N-Magi/NixieClockLogicModuleV2/readme.md

# NixieClockLogicModule v.2

new Version of NixieClock LogicModule mar fix wire ploblem

## How To Use

it's made from platformIo
open project as PIO project then connect to your microContoroller board and upload
