N-Magi/NixieClockLogicModuleV2/nixieLogicV2/nixieLogicV2.kicad_pcb

## KiCad design nixieLogicV2/nixieLogicV2.kicad_pcb (2020-12-06)

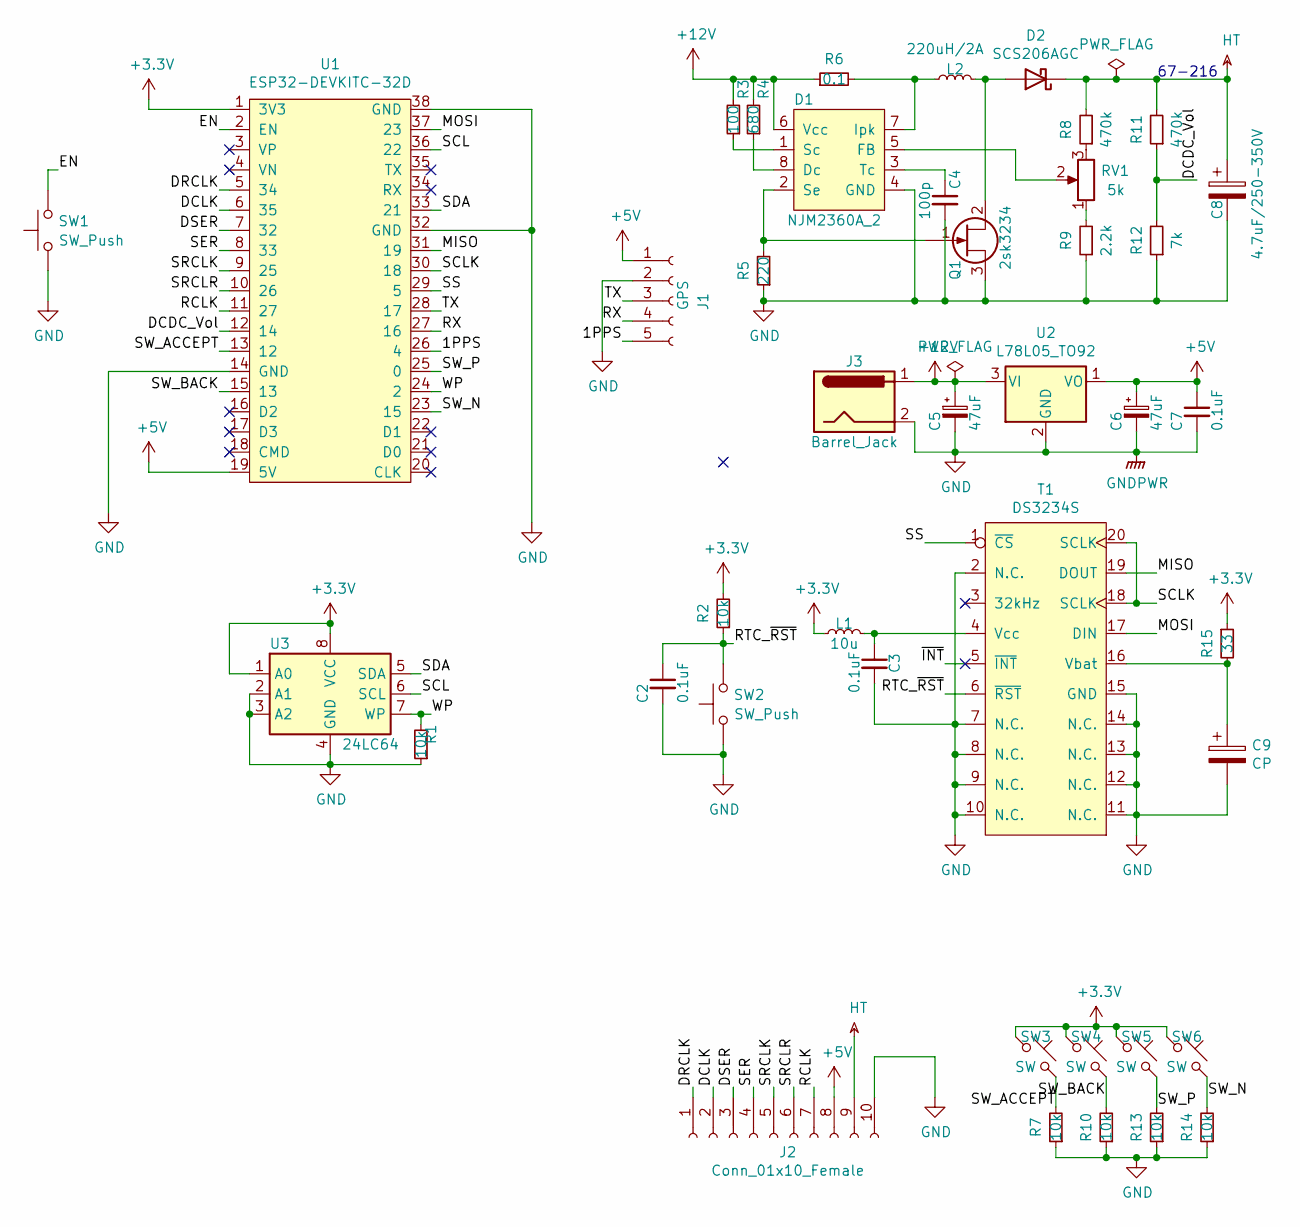
[picture p1: schematic nixieLogicV2.sch]

Parts:
C2, C3, C7: 0.1uF; C_0805_2012Metric_Pad1.15x1.40mm_HandSolder
C4: 100p; C_Rect_L7.2mm_W2.5mm_P5.00mm_FKS2_FKP2_MKS2_MKP2
C5, C6: 47uF; CP_Radial_D5.0mm_P2.00mm
C8: 4.7uF/250-350V; CP_Radial_D10.0mm_P5.00mm
C9: CP; CP_Radial_D14.0mm_P5.00mm
D1: NJM2360A_2; DIP-8_W7.62mm_Socket_LongPads
D2: SCS206AGC; TO-220-2_Horizontal_TabDown
J1: GPS; PinHeader_1x05_P2.54mm_Vertical
J2: Conn_01x10_Female; PinHeader_1x10_P2.54mm_Vertical
J3: Barrel_Jack; BarrelJack_Horizontal
L1: 10u; L_1206_3216Metric_Pad1.42x1.75mm_HandSolder
L2: 220uH/2A; L_Toroid_Vertical_L16.0mm_W8.0mm_P7.62mm
Q1: 2sk3234; TO-220-3_Horizontal_TabDown
R1, R2, R7, R10, R13, R14: 10k; R_0805_2012Metric_Pad1.15x1.40mm_HandSolder
R3: 100; R_Axial_DIN0207_L6.3mm_D2.5mm_P7.62mm_Horizontal
R4: 680; R_Axial_DIN0207_L6.3mm_D2.5mm_P7.62mm_Horizontal
R5: 220; R_Axial_DIN0207_L6.3mm_D2.5mm_P7.62mm_Horizontal
R6: 0.1; R_Axial_DIN0207_L6.3mm_D2.5mm_P15.24mm_Horizontal
R8, R11: 470k; R_Axial_DIN0207_L6.3mm_D2.5mm_P7.62mm_Horizontal
R9: 2.2k; R_Axial_DIN0207_L6.3mm_D2.5mm_P7.62mm_Horizontal
R12: 7k; R_Axial_DIN0207_L6.3mm_D2.5mm_P7.62mm_Horizontal
R15: 33; R_Axial_DIN0207_L6.3mm_D2.5mm_P7.62mm_Horizontal
RV1: 5k; Potentiometer_Vishay_T73YP_Vertical
SW1, SW2: SW_Push; SW_PUSH_6mm
SW3, SW4, SW5, SW6: SW; SW_PUSH_6mm
T1: DS3234S; SOIC-20W_7.5x12.8mm_P1.27mm
U1: ESP32-DEVKITC-32D; espWroom32devKit-C
U2: L78L05_TO92; TO-220-3_Horizontal_TabDown
U3: 24LC64; DIP-8_W7.62mm_Socket_LongPads

Connections:
+3V3: L1.1, R2.2, R15.1, SW3.1, SW4.1, SW5.1, SW6.1, U1.1 (3V3), U3.1 (A0), U3.8 (VCC)
+5V: C6.1, C7.1, J1.1, J2.8, U1.19 (5V), U2.1 (VO)
+12V: C5.1, D1.6 (Vcc), J3.1, R3.2, R4.2, R6.1, U2.3 (VI)
/1PPS: J1.5, U1.26 (4)
/DCDC_Vol: R11.1, R12.2, U1.12 (14)
/DCLK: J2.2, U1.6 (35)
/DRCLK: J2.1, U1.5 (34)
/DSER: J2.3, U1.7 (32)
/EN: SW1.2, U1.2 (EN)
/MISO: T1.19 (DOUT), U1.31 (19)
/MOSI: T1.17 (DIN), U1.37 (23)
/RCLK: J2.7, U1.11 (27)
/RTC_~RST: C2.1, R2.1, SW2.2, T1.6 (~RST)
/RX: J1.4, U1.27 (16)
/SCL: U1.36 (22), U3.6 (SCL)
/SCLK: T1.18 (SCLK), T1.20 (SCLK), U1.30 (18)
/SDA: U1.33 (21), U3.5 (SDA)
/SER: J2.4, U1.8 (33)
/SRCLK: J2.5, U1.9 (25)
/SRCLR: J2.6, U1.10 (26)
/SS: T1.1 (~CS), U1.29 (5)
/SW_ACCEPT: R7.2, SW3.2, U1.13 (12)
/SW_BACK: R10.2, SW4.2, U1.15 (13)
/SW_N: R14.2, SW6.2, U1.23 (15)
/SW_P: R13.2, SW5.2, U1.25 (0)
/TX: J1.3, U1.28 (17)
/WP: R1.2, U1.24 (2), U3.7 (WP)
/~INT: T1.5 (~INT)
GND: C2.2, C3.2, C4.2, C5.2, C6.2, C7.2, C8.2, C9.2, D1.4 (GND), J1.2, J2.10, J3.2, J3.3, Q1.3 (S), R1.1, R5.1, R7.1, R9.1, R10.1, R12.1, R13.1, R14.1, SW1.1, SW2.1, T1.2 (N.C.), T1.7 (N.C.), T1.8 (N.C.), T1.9 (N.C.), T1.10 (N.C.), T1.11 (N.C.), T1.12 (N.C.), T1.13 (N.C.), T1.14 (N.C.), T1.15 (GND), U1.14 (GND), U1.32 (GND), U1.38 (GND), U2.2 (GND), U3.2 (A1), U3.3 (A2), U3.4 (GND)
HT: C8.1, D2.1 (K), J2.9, R8.2, R11.2
unnamed: C3.1, L1.2, T1.4 (Vcc)
unnamed: C4.1, D1.3 (Tc)
unnamed: C9.1, R15.2, T1.16 (Vbat)
unnamed: D1.1 (Sc), R3.1
unnamed: D1.2 (Se), Q1.1 (G), R5.2
unnamed: D1.5 (FB), RV1.2
unnamed: D1.7 (Ipk), L2.1, R6.2
unnamed: D1.8 (Dc), R4.1
unnamed: D2.2 (A), L2.2, Q1.2 (D)
unnamed: R8.1, RV1.3
unnamed: R9.2, RV1.1

Notes on the sheet:
67-216

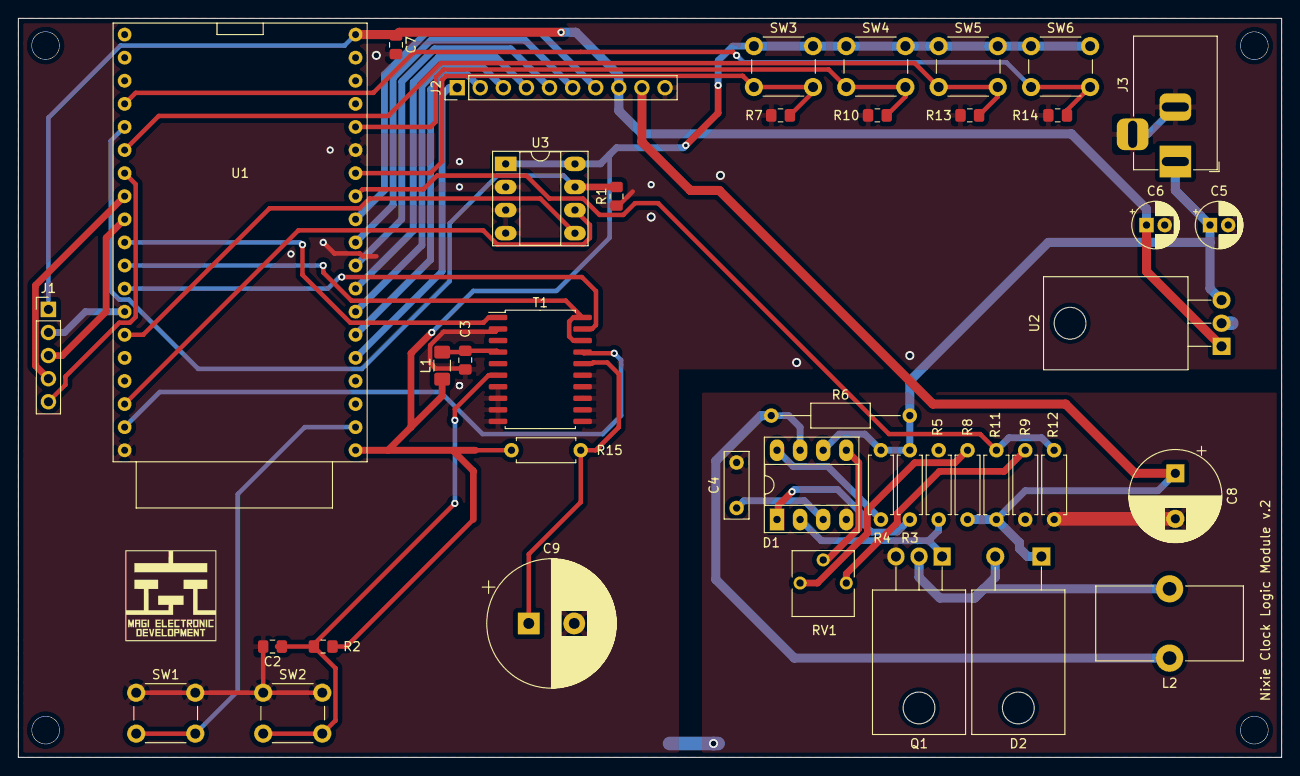
[picture p2: board nixieLogicV2.kicad_pcb from above]

Board: 2 copper layers, 138.9 x 81.3 mm, 42 parts (0 on the bottom side), 40 nets.
